jorisdobbelsteen/SpinningLED/Axis/Axis-STM32F411/Images/black_and_white_cat.jpg

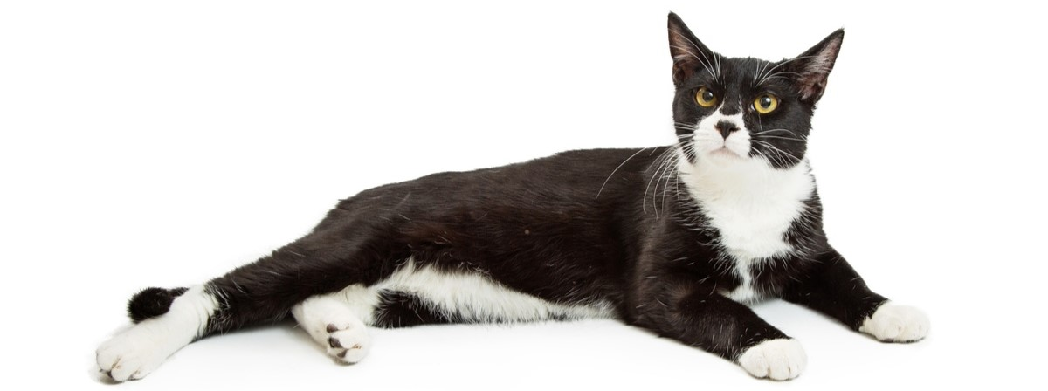
Axis/Axis-STM32F411/Images/black_and_white_cat.jpg
