jorisdobbelsteen/SpinningLED/Documentation/Spinning LED Design Calculations.xlsx

Sheet: Centrifugal Force & Speed
Inputs
Arm Weight | 200 | g | 0.2 | kg
PLA Failure | 40 | MPa |  |  | eSun PLA+ tensile strength is 60 Mpa
PLA support | 225 | mm2 | 0.000225 | m2
PLA force | 9000 | N |  |  | 1 Pa = 1 N/m2
F = mω2r
Centrifugal force (N)
 | Angular velocity
round/sec | 15 | 18 | 20 | 22 | 24 | 25 | 30 | 35 | 40 | 45 | 50
rpm | 900 | 1080 | 1200 | 1320 | 1440 | 1500 | 1800 | 2100 | 2400 | 2700 | 3000
rad/sec | 94.2 | 113.1 | 125.7 | 138.2 | 150.8 | 157.1 | 188.5 | 219.9 | 251.3 | 282.7 | 314.2
Radius (m)
0.2 | 355.3057584 | 511.6402922 | 631.6546817 | 764.3021648 | 909.5827416 | 986.9604401 | 1421.223034 | 1934.442463 | 2526.618727 | 3197.751826 | 3947.84176
0.25 | 444.132198 | 639.5503652 | 789.5683521 | 955.377706 | 1136.978427 | 1233.70055 | 1776.528792 | 2418.053078 | 3158.273408 | 3997.189782 | 4934.802201
0.3 | 532.9586377 | 767.4604382 | 947.4820225 | 1146.453247 | 1364.374112 | 1480.44066 | 2131.834551 | 2901.663694 | 3789.92809 | 4796.627739 | 5921.762641
0.35 | 621.7850773 | 895.3705113 | 1105.395693 | 1337.528788 | 1591.769798 | 1727.18077 | 2487.140309 | 3385.27431 | 4421.582772 | 5596.065695 | 6908.723081
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
