jorisdobbelsteen/SpinningLED/CAD/KiCAD/kicad_templates/Alchitry_Au/meta/board.png

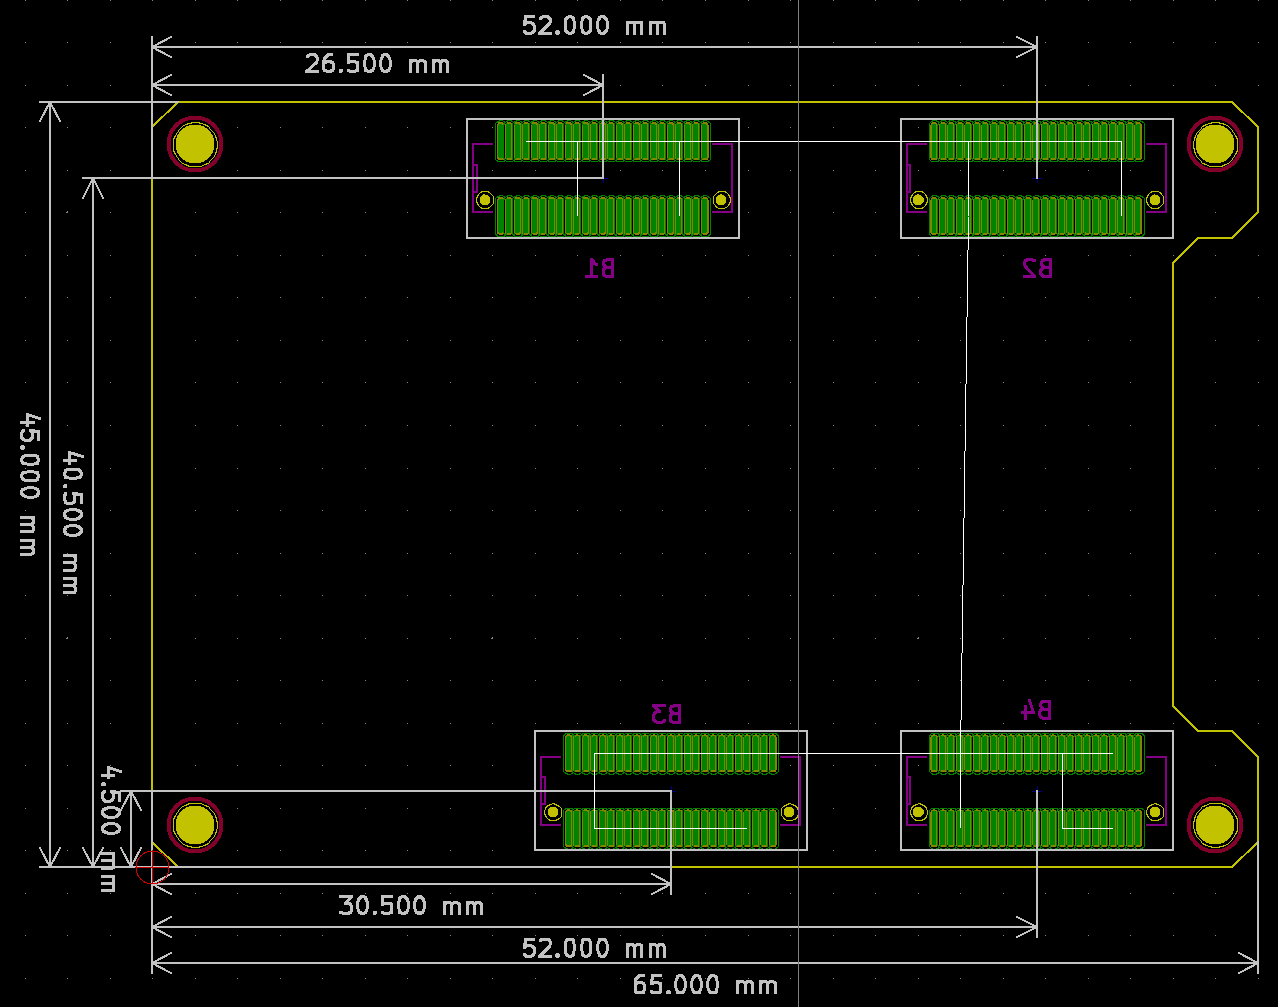
CAD/KiCAD/kicad_templates/Alchitry_Au/meta/board.png
