jorisdobbelsteen/SpinningLED/CAD/KiCAD/kicad_templates/Sierra 2 layer Board/meta/Images/schematic.jpg

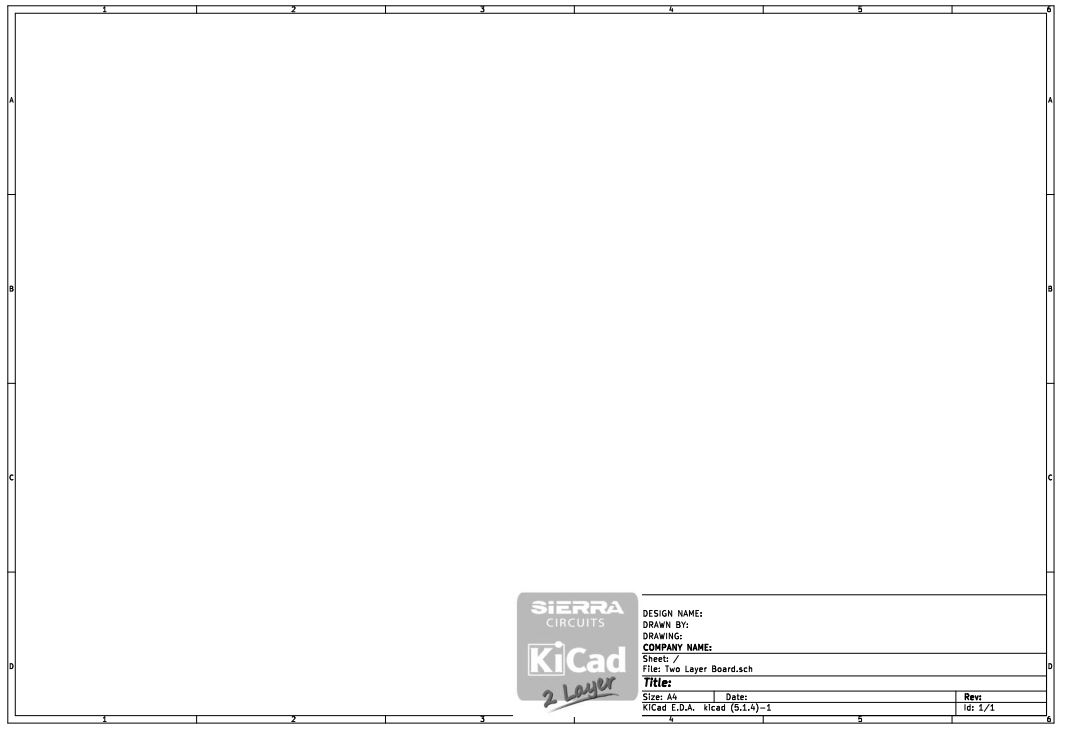
CAD/KiCAD/kicad_templates/Sierra 2 layer Board/meta/Images/schematic.jpg
