jorisdobbelsteen/SpinningLED/CAD/KiCAD/kicad_templates/Sierra 2 layer Board/meta/Images/Text & Graphics.JPG

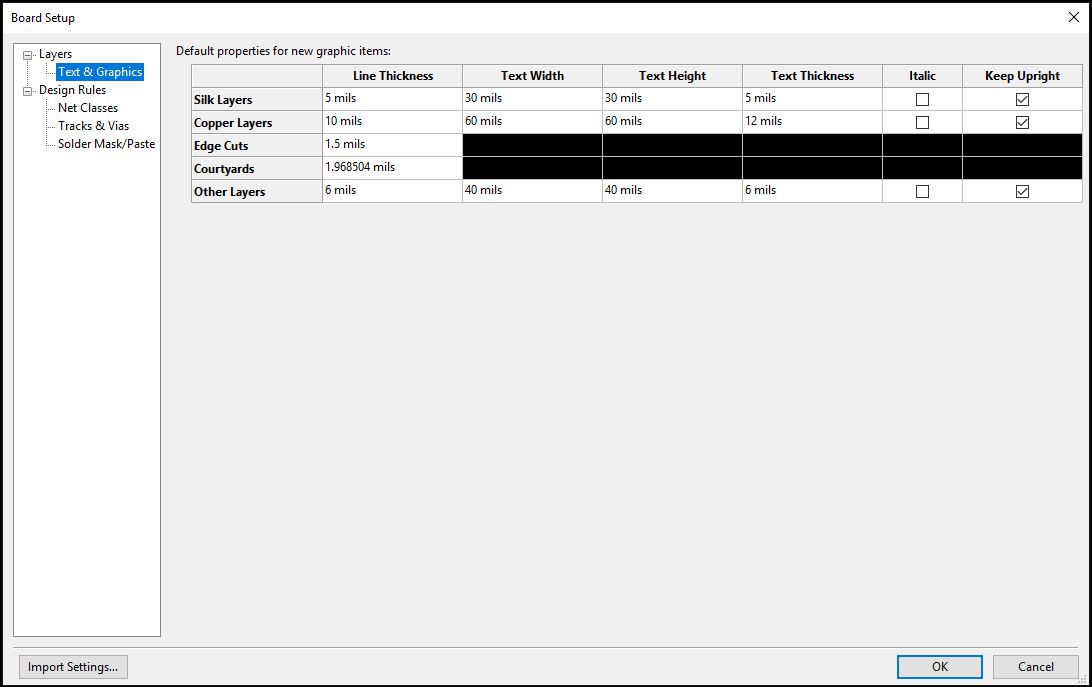
CAD/KiCAD/kicad_templates/Sierra 2 layer Board/meta/Images/Text & Graphics.JPG
