jorisdobbelsteen/SpinningLED/CAD/KiCAD/kicad_templates/Sierra 2 layer Board/meta/Images/Trace & Vias.JPG

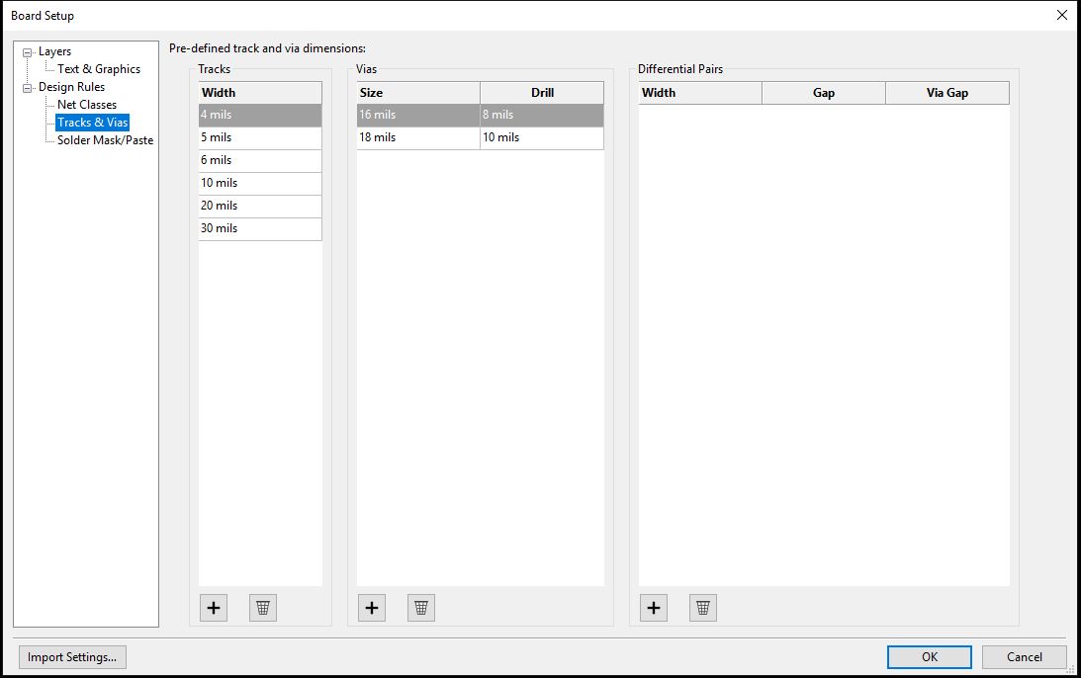
CAD/KiCAD/kicad_templates/Sierra 2 layer Board/meta/Images/Trace & Vias.JPG
