jorisdobbelsteen/SpinningLED/CAD/KiCAD/kicad_templates/Sierra 6 layer Board/meta/Images/Layers.JPG

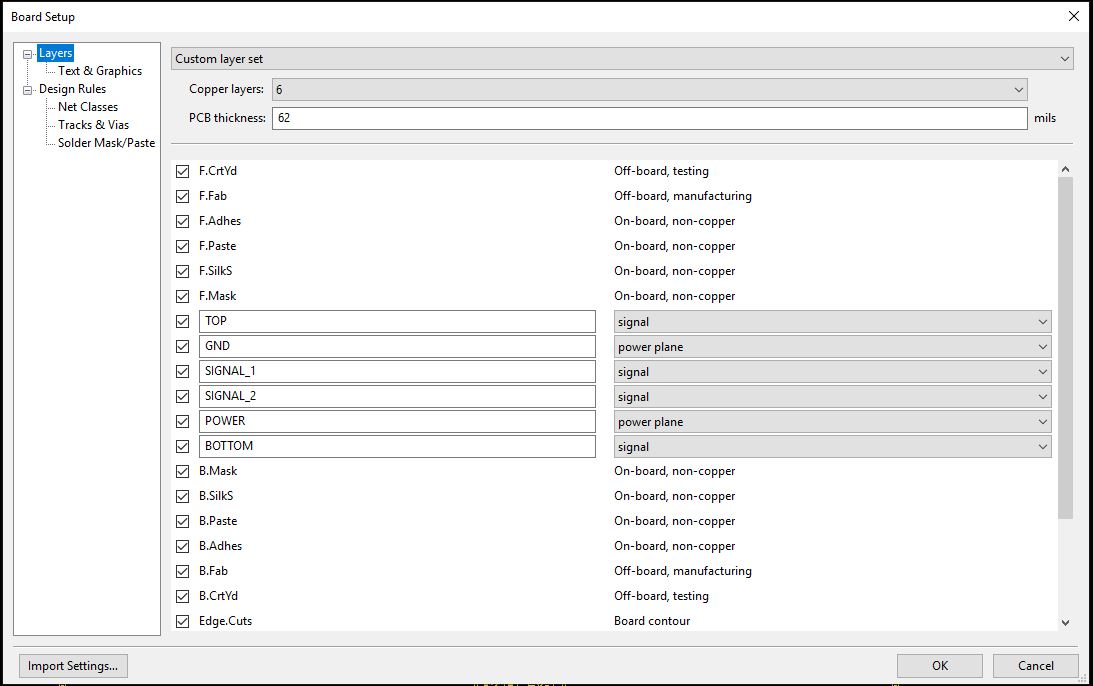
CAD/KiCAD/kicad_templates/Sierra 6 layer Board/meta/Images/Layers.JPG
