jorisdobbelsteen/SpinningLED/CAD/KiCAD/kicad_templates/Sierra 8 layer Board/meta/Images/layout.jpg

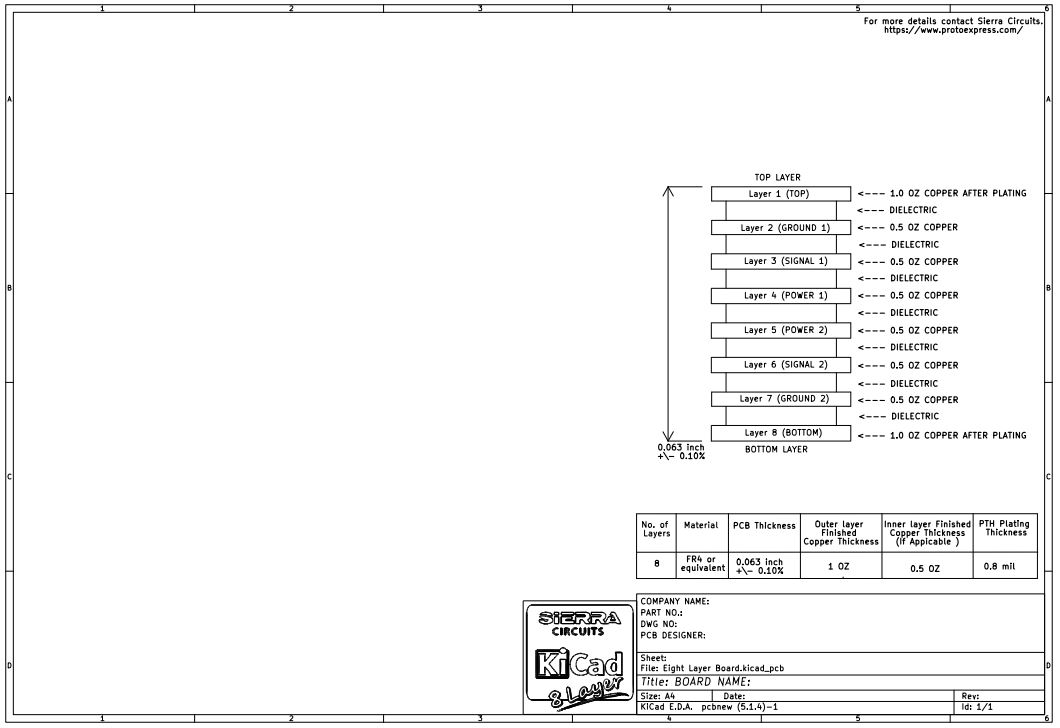
CAD/KiCAD/kicad_templates/Sierra 8 layer Board/meta/Images/layout.jpg
