jorisdobbelsteen/SpinningLED/Boards/AxisPCB/AxisPCB-STM32F411/AxisPCB-STM32F411.kicad_pcb

## KiCad design Boards/AxisPCB/AxisPCB-STM32F411/AxisPCB-STM32F411.kicad_pcb (2023-06-07)

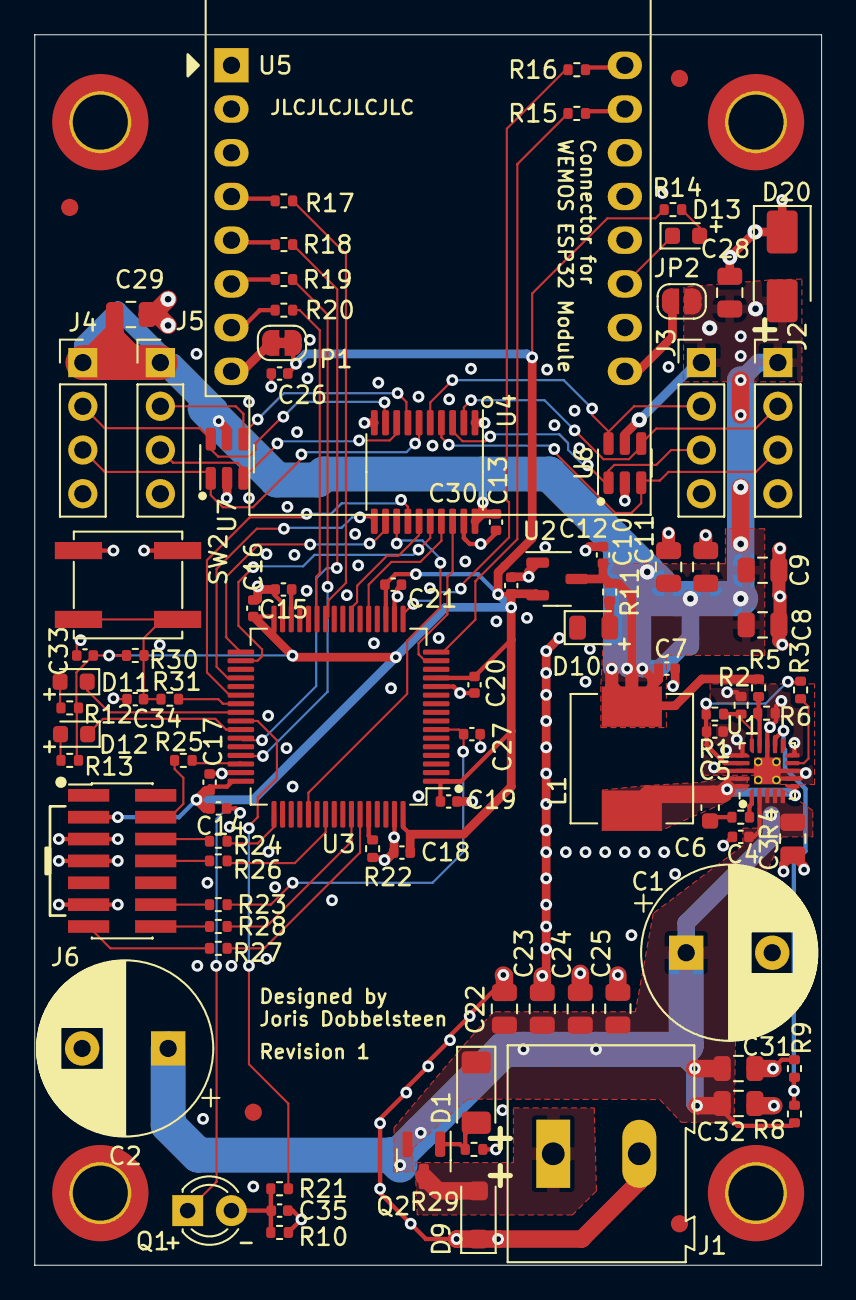
[picture p18: board AxisPCB-STM32F411.kicad_pcb from above]

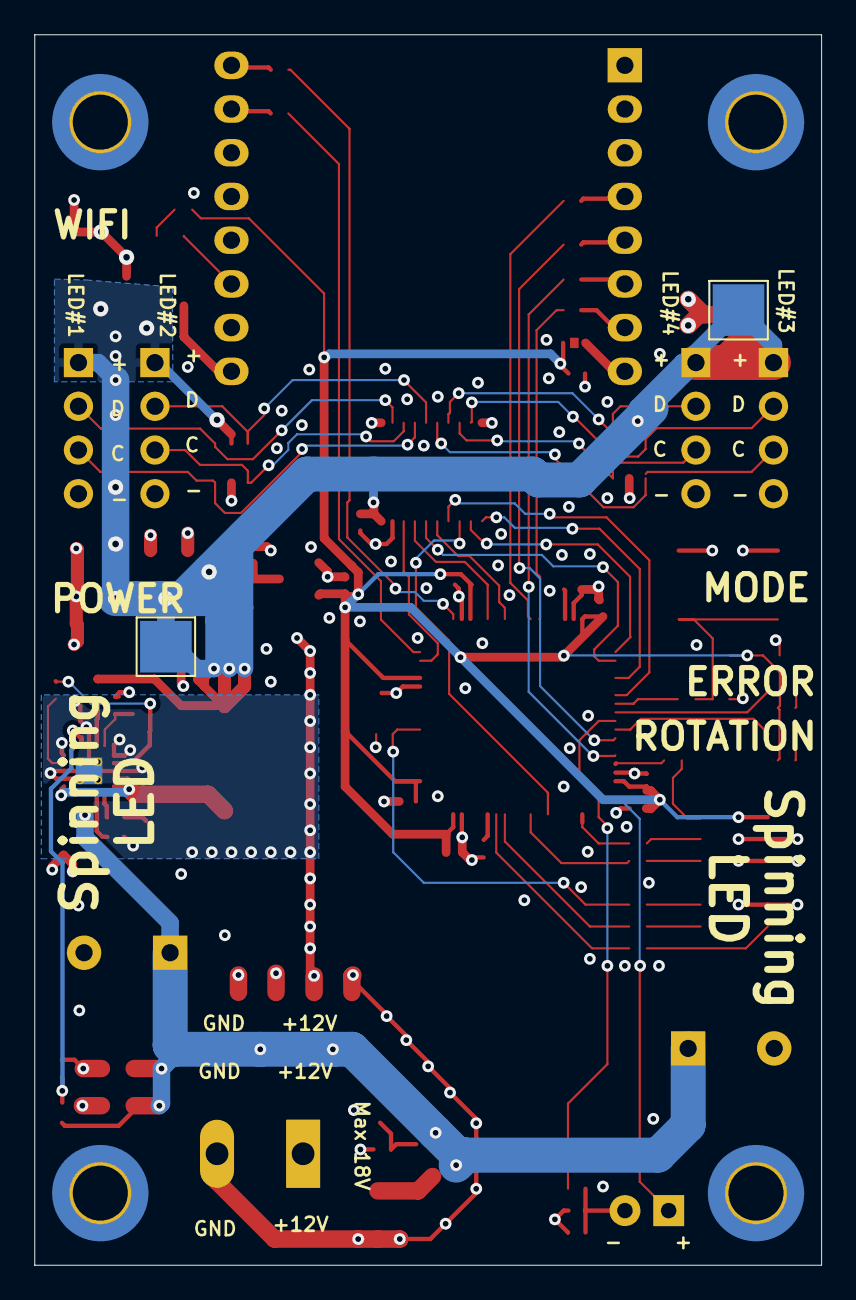
[picture p19: board AxisPCB-STM32F411.kicad_pcb from below]

Board: 4 copper layers, 45.7 x 71.5 mm, 101 parts (2 on the bottom side), 69 nets.

Parts:
C1, C2: 470u; CP_Radial_D10.0mm_P5.00mm
C3, C22, C23, C24, C25, C31, C32: 22u; C_0805_2012Metric
C4, C5, C12, C13, C33: 1u; C_0402_1005Metric
C6: 4u7; C_0603_1608Metric
C7, C16, C17, C18, C19, C20, C21, C27, C30, C34, C35: 0.1u; C_0402_1005Metric
C8, C9, C10, C11, C28, C29: 47u; C_0805_2012Metric
C14, C15, C26: 4.7u; C_0402_1005Metric
D1: ZMM5V6-M; D_MiniMELF
D9: SMF30CA; D_SOD-123F
D10: GREEN LED; LED_0805_2012Metric
D11: RED LED; LED_0603_1608Metric
D12: YELLOW LED; LED_0603_1608Metric
D13: BLUE LED; LED_0603_1608Metric
D20: SMAJ5.0A; D_SMA
FID1, FID2, FID3, FID4: Fiducial; Fiducial_1mm_Mask2mm
H1, H2, H3, H4: M3 Hole; MountingHole_3.2mm_M3_DIN965_Pad_TopBottom
J1: Conn_01x02_Pin; TerminalBlock_Altech_AK300-2_P5.00mm
J2, J3, J4, J5: Conn_01x04; PinHeader_1x04_P2.54mm_Vertical
J6: Conn_ST_STDC14; PinHeader_2x07_P1.27mm_Vertical_SMD
JP1: SolderJumper_2_Bridged; SolderJumper-2_P1.3mm_Bridged_RoundedPad1.0x1.5mm
JP2: SolderJumper_2_Open; SolderJumper-2_P1.3mm_Open_RoundedPad1.0x1.5mm
L1: 1.5u; L_Sunlord_MWSA0603S
Q1: INL-3APT30; LED_D3.0mm_Clear
Q2: AO3401A; SOT-23
R1: 330k 1%; R_0402_1005Metric
R2: 15k 1%; R_0402_1005Metric
R3: 100k; R_0402_1005Metric
R4: 0R; R_0402_1005Metric
R5: 200k 1%; R_0402_1005Metric
R6: 27k 1%; R_0402_1005Metric
R8: 200k; R_0402_1005Metric
R9: 51k; R_0402_1005Metric
R10, R29: 2K; R_0402_1005Metric
R11: 2.4k; R_0402_1005Metric
R12, R14, R31: 680R; R_0402_1005Metric
R13: 1.5k; R_0402_1005Metric
R15, R16, R17, R18, R19, R20, R23, R24, R25, R26: 22R; R_0402_1005Metric
R21, R27, R28: 100R; R_0402_1005Metric
R22, R30: 10k; R_0402_1005Metric
SW2: USER; SW_SPST_EVPBF
TP1, TP2: VCC; TestPoint_Pad_3.0x3.0mm
U1: TPS51396ARJER; VQFN-20-1EP_3x3mm_P0.45mm_EP1.55x1.55mm_ThermalVias
U2: XC6206P332MR; SOT-23-3
U3: STM32F411R_C-E_Tx; LQFP-64_10x10mm_P0.5mm
U4: 74AHCT245PW; TSSOP-20_4.4x6.5mm_P0.65mm
U5: WeMos_D1_mini; WEMOS_D1_mini_light
U6, U7: SRV05-4; SOT-23-6

Connections:
+3.3V: C13.1, C14.1, C16.2, C17.1, C18.1, C19.1, C20.1, C21.1, C26.1, C33.1, J6.3 (VCC), JP1.1 (A), Q1.1 (C), R12.1, R13.2, R14.2, R30.1, U2.2 (VO), U3.1 (VBAT), U3.13 (VDDA), U3.19 (VDD), U3.32 (VDD), U3.48 (VDD), U3.64 (VDD)
+5V: C7.1, C8.1, C9.1, C10.1, C11.1, C12.1, C28.1, C29.1, C30.1, D20.2 (A2), J2.1, J3.1, J4.1, J5.1, JP2.1 (A), L1.2, R5.1, R11.1, TP1.1, TP2.1, U2.3 (VI), U4.20 (VCC), U6.5 (VP), U7.5 (VP)
+12V: C1.1, C2.1, C3.1, C4.1, C22.1, C23.1, C24.1, C25.1, C31.1, C32.1, D1.1 (K), Q2.2 (S), R8.1, U1.2 (VIN), U1.3 (VIN_2), U1.4 (VIN_3), U1.5 (VIN_4)
/+12V_PIN: D9.2 (A2), J1.1, Q2.3 (D)
/SMPS 5V 8A/SW: C6.1, L1.1, U1.6 (SW), U1.19 (SW_2), U1.20 (SW_3)
/SMPS 5V 8A/VCC: C5.1, R1.1, R3.1, U1.17 (VCC)
BOOT0: R22.1, U3.60 (BOOT0)
ERROR_LED: D11.1 (K), U3.40 (PC9)
GND: C1.2, C2.2, C3.2, C4.2, C5.2, C7.2, C8.2, C9.2, C10.2, C11.2, C12.2, C13.2, C14.2, C15.2, C16.1, C17.2, C18.2, C19.2, C20.2, C21.2, C22.2, C23.2, C24.2, C25.2, C26.2, C27.2, C28.2, C29.2, C30.2, C31.2, C32.2, C33.2, C34.2, C35.1, D9.1 (A1), D10.1 (K), D20.1 (A1), H1.1, H2.1, H3.1, H4.1, J1.2, J2.4, J3.4, J4.4, J5.4, J6.5 (GND), J6.7 (GND), J6.11 (GNDDetect), R2.2, R6.2, R9.2, R10.2, R22.2, R29.2, SW2.1, U1.7 (GND), U1.8 (GND_2), U1.10 (NC_1), U1.13 (AGND), U1.16 (NC_2), U1.18 (GND_3), U1.21 (GND_4), U2.1 (GND), U3.12 (VSSA), U3.18 (VSS), U3.31 (VSS), U3.47 (VSS), U3.63 (VSS), U4.1 (A->B), U4.10 (GND), U4.19 (CE), U5.10 (GND), U6.2 (VN), U7.2 (VN)
LS1_C: J2.3, U4.4 (A2), U6.3 (IO2)
LS1_D: J2.2, U4.2 (A0), U6.4 (IO3)
LS2_C: J3.3, U4.3 (A1), U6.1 (IO1)
LS2_D: J3.2, U4.5 (A3), U6.6 (IO4)
LS3_C: J4.3, U4.6 (A4), U7.1 (IO1)
LS3_D: J4.2, U4.9 (A7), U7.6 (IO4)
LS4_C: J5.3, U4.8 (A6), U7.3 (IO2)
LS4_D: J5.2, U4.7 (A5), U7.4 (IO3)
NRST: C27.1, R23.1, U3.7 (NRST)
unnamed: C6.2, R4.2
unnamed: C34.1, R30.2, R31.2, SW2.2
unnamed: D1.2 (A), Q2.1 (G), R29.1
unnamed: D10.2 (A), R11.2
unnamed: D11.2 (A), R12.2
unnamed: D12.2 (A), R13.1
unnamed: D13.2 (A), R14.1
unnamed: J6.6 (JCLK/SWCLK), R24.2
unnamed: J6.8 (JTDO/SWO), R26.2
unnamed: J6.4 (JTMS/SWDIO), R25.2
unnamed: J6.13 (VCP_RX), R27.1
unnamed: J6.14 (VCP_TX), R28.1
unnamed: J6.12 (~RST), R23.2
unnamed: JP1.2 (B), U5.8 (3V3)
unnamed: JP2.2 (B), U5.9 (5V)
unnamed: C35.2, Q1.2 (E), R10.1, R21.1
unnamed: R4.1, U1.1 (BST)
unnamed: R5.2, R6.1, U1.14 (FB)
unnamed: R1.2, R2.1, U1.15 (MODE)
unnamed: R3.2, U1.9 (PGOOD)
unnamed: C15.1, U3.30 (VCAP1)
unnamed: R20.2, U5.7 (CS/D8)
unnamed: R18.2, U5.5 (MISO/D6)
unnamed: R19.2, U5.6 (MOSI/D7)
unnamed: R15.1, U5.15 (RX)
unnamed: R17.2, U5.4 (SCK/D5)
unnamed: R16.2, U5.16 (TX)
ROTATION_LED: D12.1 (K), U3.42 (PA9)
ROT_DETECT: R21.2, U3.41 (PA8)
SMPS_EN: R8.2, R9.1, U1.12 (EN)
SPI1_MOSI: U3.23 (PA7), U4.15 (B3)
SPI1_SCK: U3.21 (PA5), U4.17 (B1)
SPI2_MOSI: U3.36 (PB15), U4.11 (B7)
SPI2_SCK: U3.38 (PC7), U4.14 (B4)
SPI3_MOSI: U3.53 (PC12), U4.13 (B5)
SPI3_SCK: U3.33 (PB12), U4.12 (B6)
SPI4_MOSI: U3.15 (PA1), U4.18 (B0)
SPI4_SCK: U3.34 (PB13), U4.16 (B2)
SPI5_MISO: R19.1, U3.45 (PA12)
SPI5_MOSI: R18.1, U3.43 (PA10)
SPI5_NSS: R20.1, U3.27 (PB1)
SPI5_SCK: R17.1, U3.26 (PB0)
SWD_SWO: R26.1, U3.55 (PB3)
SWD_TCK: R24.1, U3.49 (PA14)
SWD_TMS: R25.1, U3.46 (PA13)
USART1_RX: R27.2, U3.59 (PB7)
USART1_TX: R28.2, U3.58 (PB6)
USART2_RX: R16.1, U3.17 (PA3)
USART2_TX: R15.2, U3.16 (PA2)
USER: R31.1, U3.39 (PC8)
WIFI_STAT_LED: D13.1 (K), U5.11 (D4)
