jorisdobbelsteen/SpinningLED/MotorController/MotorPWM-STM32F303/Core/Src/main.c

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
/* Includes ------------------------------------------------------------------*/
#include "main.h"

/* USER CODE BEGIN Includes */
#include <stdio.h>
#include "button.h"
#include "status_led.h"
#include "motor_control.h"
#include "rotation_sensor.h"
#include "PID.h"
/* USER CODE END Includes */

/* USER CODE BEGIN PTD */
typedef enum state_t {
  /* Note: FATAL_ERROR is handled by program counter, stuck in ErrorHandler() */
  /* STATE               PWM        LED               NEXT_STATE                             */
  STATE_ERROR,        // off        ERROR             btn_stop                  -> STOPPED
  STATE_INIT,         // off        INIT              both_button && powercycle -> CALIBRATE
                      //                              else                      -> STOPPED
  STATE_CALIBRATION,  // on (max)   TROTTLE_CALIB     !both_button              -> STOPPED
                      //                              break                     -> ERROR
  STATE_STOP,         // on (min)   STOPPING /        start_pressed             -> START
                      //            STOPPED           break                     -> ERROR
  STATE_START         // on (PID)   STARTING /        stop_pressed              -> STOP
                      //            STARTED           out_of_limits             -> ERROR
                      //                              break                     -> ERROR
} state_t;
/* USER CODE END PTD */

/* USER CODE BEGIN PD */
#define PULSES_PER_ROTATION 12
#define ROTATIONS_PER_SEC 15
#define RAMP_PULSE_PER_SEC (PULSES_PER_ROTATION * 1 / 4)
#define OVERSPEED_PULSES_PER_SEC (10 * PULSES_PER_ROTATION)
#define UNDERSPEED_PULSES_PER_SEC (10 * PULSES_PER_ROTATION)
#define STABLE_PULSES_PER_SEC (PULSES_PER_ROTATION / 2)
#define PID_PRESCALER 4

/* USER CODE END PD */

TIM_HandleTypeDef htim2;
TIM_HandleTypeDef htim3;
TIM_HandleTypeDef htim6;
TIM_HandleTypeDef htim15;
TIM_HandleTypeDef htim17;

UART_HandleTypeDef huart2;
DMA_HandleTypeDef hdma_usart2_tx;

/* USER CODE BEGIN PV */
static state_t global_state;
static int init_allow_calibration;
static uint32_t init_enter_tick;
static PIDController control_pid;
static volatile unsigned int control_pid_tick_counter;
static unsigned int control_pid_last_tick_counter;
static volatile int control_setpoint_millipulsesec;
static volatile int control_error;
static volatile int control_stable;
static int control_last_pulse_count;
static int control_setpoint_internal_millipulsesec;
static int control_prescaler_pid;
static int start_stop_stable;
/* USER CODE END PV */

void SystemClock_Config(void);
static void MX_GPIO_Init(void);
static void MX_DMA_Init(void);
static void MX_TIM17_Init(void);
static void MX_USART2_UART_Init(void);
static void MX_TIM2_Init(void);
static void MX_TIM3_Init(void);
static void MX_TIM15_Init(void);
static void MX_TIM6_Init(void);
/* USER CODE BEGIN 0 */

static void PID_init(void) {
  control_pid.Kp = 0.060f;
  control_pid.Ki = 0.006f;
  control_pid.Kd = 0.003f;
  control_pid.tau = 0.4f;              // derivative filter time constant
  control_pid.limMin = 0.0f;
  control_pid.limMax = 0.4f;           // cap of output power
  control_pid.limMinInt = -0.1f;
  control_pid.limMaxInt = 0.4f;
  control_pid.T = 0.02f * PID_PRESCALER;

  PIDController_Init(&control_pid);

  control_error = 0;
  control_stable = 0;
  control_setpoint_millipulsesec = 0;
  control_setpoint_internal_millipulsesec = 0;
}

static void PID_tick(void) {
  control_pid_tick_counter++;

  // Load from volatile value
  int final_setpoint = control_setpoint_millipulsesec;

  // Slowly ramp to final setpoint
  int setpoint_e = final_setpoint - control_setpoint_internal_millipulsesec;
  int increment = RAMP_PULSE_PER_SEC * 1000 * control_pid.T;
  int decrement = -5 * RAMP_PULSE_PER_SEC * 1000 * control_pid.T;
  if (setpoint_e > increment)
    setpoint_e = increment;
  else if (setpoint_e < decrement)
    setpoint_e = decrement;
  control_setpoint_internal_millipulsesec += setpoint_e;

  // Acquire current speed
  int millipulses_per_sec = rotation_sensor_get_millipulses_per_sec();
  // Derive from measured ticks
  //
  // Unless the PULSES_PER_ROTATION or measurement period is large enough, this is rather inaccurate...
  // For PULSES_PER_ROTATION 12:
  //   15 rpm -> 180 ticks / sec = 3.6 ticks / 20 ms     -> 3 ~ 4 ticks gives 12.5 ~ 16.6 rpm
  //                             = 14,4 ticks / 80 ms   -> 14 ~ 15 ticks gives 14.6 ~ 16.6 rpm
  // To calculate
  //   1 tick / t ms / x ticks/rotation = 0.1 rps ->
  //   1 / t / 0.1 = x                            -> x = 10 / t
  //   * 20 ms --> 500 ticks / rotation
  //   * 80 ms --> 125 ticks / rotation
//  uint_rotation_t pc = rotation_sensor_get_counter();
//  uint_rotation_t delta_pulse = pc - control_last_pulse_count;
//  control_last_pulse_count = pc;
//  int millipulses_per_sec_c = 1000 * pc / control_pid.T;

  // Safety/Sanity check
  if (millipulses_per_sec > control_setpoint_internal_millipulsesec + OVERSPEED_PULSES_PER_SEC * 1000
      || millipulses_per_sec + UNDERSPEED_PULSES_PER_SEC * 1000 < control_setpoint_internal_millipulsesec) {
    control_error = 1;
    motor_control_set_pulse(MOTOR_PWM_MIN);
    return;
  }

  // PID loop
  float out = PIDController_Update(&control_pid,
                                   control_setpoint_internal_millipulsesec / (1000.0f * PULSES_PER_ROTATION),
                                   millipulses_per_sec / (1000.0f * PULSES_PER_ROTATION));

  // Set output
  motor_control_set_pulse(MOTOR_PWM_MIN + (int)(out * (MOTOR_PWM_MAX - MOTOR_PWM_MIN)));

  // Determine if loop is stable
  int final_error = millipulses_per_sec - final_setpoint;
  control_stable = final_error > -STABLE_PULSES_PER_SEC * 1000
          && final_error < STABLE_PULSES_PER_SEC * 1000;
}

static void PID_print_stats(void) {
  unsigned int c = control_pid_tick_counter;
  if (c == control_pid_last_tick_counter)
    return;
  control_pid_last_tick_counter = c;

  printf("%03d  m %2.3f e %2.3f o %1.4f   i %1.4f d %1.4f\n",
         c % 1000,
         control_pid.prevMeasurement,
         control_pid.prevError,
         control_pid.out,
         control_pid.integrator,
         control_pid.differentiator);
}

static void enter_state(state_t state) {
  switch (state) {
    case STATE_ERROR:
      status_led_set(STATUS_LED_MODE_ERROR);
      puts("ERROR");
      motor_control_stop();
      break;
    case STATE_INIT:
      status_led_set(STATUS_LED_MODE_INIT);
      puts("INIT");
      init_enter_tick = HAL_GetTick();
      break;
    case STATE_CALIBRATION:
      status_led_set(STATUS_LED_MODE_THROTTLE_CALIB);
      puts("CALIBRATE");
      motor_control_start(MOTOR_PWM_MAX); // Set to maximum speed
      break;
    case STATE_STOP:
      status_led_set(STATUS_LED_MODE_STOPPING);
      puts("STOP");
      start_stop_stable = 0;
      motor_control_start(MOTOR_PWM_MIN); // Set to minimum speed
      break;
    case STATE_START:
      status_led_set(STATUS_LED_MODE_STARTING);
      puts("START");
      start_stop_stable = 0;
      PID_init();
      control_setpoint_millipulsesec = ROTATIONS_PER_SEC * PULSES_PER_ROTATION * 1000;
      control_last_pulse_count = rotation_sensor_get_counter();
      motor_control_start_update_interrupt();
      break;
    // NOTE: Rely on compiler to give warning when this is incomplete
  }
}

static void exit_state(state_t state) {
  switch (state) {
    case STATE_ERROR:
      rotation_sensor_reset();
      break;
    case STATE_INIT:
      init_allow_calibration = 0;
      buttons_reset(); // ignore any pending presses
      break;
    case STATE_CALIBRATION:
      motor_control_set_pulse(MOTOR_PWM_MIN);
      buttons_reset(); // ignore any pending presses
      break;
    case STATE_STOP:
      break;
    case STATE_START:
      motor_control_stop_update_interrupt();
      break;
    // Rely on compiler to give warning when this is incomplete
  }
}

static void set_state(state_t next_state) {
  state_t previous_state = global_state;
  if (next_state != previous_state) {
    // Exit state is not aware which exit is performed
    exit_state(previous_state);
    // In enter_state, we can use "global_state" to get the next state
    enter_state(next_state);
    global_state = next_state;
  }
}

void buttons_start_pressed(void) {
  switch (global_state) {
    case STATE_STOP:
      set_state(STATE_START);
      break;
    default:
      break;
  }
}

void buttons_stop_pressed(void) {
  switch (global_state) {
    case STATE_ERROR:
      set_state(STATE_STOP);
      break;
    case STATE_START:
      set_state(STATE_STOP);
      break;
    default:
      break;
  }
}

void HAL_TIM_PeriodElapsedCallback(TIM_HandleTypeDef *htim)
{
  if (htim == &MotorTimer) {
    if (global_state == STATE_START) { // sanity check if we really should run the PWM
      if (control_error != 0) {
        motor_control_set_pulse(MOTOR_PWM_MIN);
        control_error++;
      } else {
        if (++control_prescaler_pid >= PID_PRESCALER) {
          PID_tick();
        }
      }
    } else {
      Error_Handler();
    }
  } /*else if (htim == &ButtonTimer) {
    IT_buttons_check();
  } */
}

void HAL_TIMEx_BreakCallback(TIM_HandleTypeDef *htim) {
  if (htim == &MotorTimer) {
    IT_motor_control_break();
  }
}

static void loop(void) {
  // Check motor state...
  if (motor_control_get_state() == MOTOR_CONTROL_BREAK) {
    puts("Motor BREAK detected");
    set_state(STATE_ERROR);
  }

  buttons_check();

  switch (global_state) {
    case STATE_INIT:
      // Ticks are in milliseconds
      if (HAL_GetTick() - init_enter_tick > 2000) {
        set_state(STATE_STOP);
      } else if (init_allow_calibration && buttons_both_pressed()) {
        set_state(STATE_CALIBRATION);
      }
      break;
    case STATE_CALIBRATION:
      if (!buttons_both_pressed()) {
        set_state(STATE_STOP);
      }
      break;
    case STATE_STOP: {
      const int stable = rotation_sensor_get_millipulses_per_sec() <= 333; // no pulse for 3 seconds
      if (stable != start_stop_stable) {
        status_led_set(stable ? STATUS_LED_MODE_STOPPED : STATUS_LED_MODE_STOPPING);
        start_stop_stable = stable;
      }
    } break;
    case STATE_START: {
      const int stable = control_stable;
      if (control_error > 5) { // give several pulses to allow setting PWM to minimum
        puts("Control ERROR detected");
        set_state(STATE_ERROR);
      } else  if (stable != start_stop_stable) {
        status_led_set(stable ? STATUS_LED_MODE_STARTED : STATUS_LED_MODE_STARTING);
        start_stop_stable = stable;
      }
      PID_print_stats();
    } break;
    default:
      break;
  }
}

/* USER CODE END 0 */

/**
  * @brief  The application entry point.
  * @retval int
  */
int main(void)
{
  /* MCU Configuration--------------------------------------------------------*/

  /* Reset of all peripherals, Initializes the Flash interface and the Systick. */
  HAL_Init();

  /* USER CODE BEGIN Init */

  HAL_SetTickFreq(HAL_TICK_FREQ_100HZ);

  /* USER CODE END Init */

  /* Configure the system clock */
  SystemClock_Config();

  /* USER CODE BEGIN SysInit */

  init_allow_calibration =
    !__HAL_RCC_GET_FLAG(RCC_FLAG_OBLRST) && // Option Byte Load reset
    // normal start has PIN reset !__HAL_RCC_GET_FLAG(RCC_FLAG_PINRST) && // Pin reset
    !__HAL_RCC_GET_FLAG(RCC_FLAG_PORRST) && // POR/PDR reset.
    !__HAL_RCC_GET_FLAG(RCC_FLAG_SFTRST) &&  // Software reset.
    !__HAL_RCC_GET_FLAG(RCC_FLAG_IWDGRST) && // Independent Watchdog reset.
    !__HAL_RCC_GET_FLAG(RCC_FLAG_WWDGRST) && // Window Watchdog reset.
    !__HAL_RCC_GET_FLAG(RCC_FLAG_LPWRRST); // Low Power Reset
  __HAL_RCC_CLEAR_RESET_FLAGS();

  /* USER CODE END SysInit */

  /* Initialize all configured peripherals */
  MX_GPIO_Init();
  MX_DMA_Init();
  MX_TIM17_Init();
  MX_USART2_UART_Init();
  MX_TIM2_Init();
  MX_TIM3_Init();
  MX_TIM15_Init();
  MX_TIM6_Init();
  /* USER CODE BEGIN 2 */

  PID_init();

  buttons_init();
  status_led_init();
  motor_control_init();
  rotation_sensor_init();

  /* USER CODE END 2 */

  /* Infinite loop */
  /* USER CODE BEGIN WHILE */

  global_state = STATE_INIT;
  enter_state(global_state);

  while (1)
  {
    loop();
    /* USER CODE END WHILE */

    /* USER CODE BEGIN 3 */

    HAL_GPIO_TogglePin(LD3_GPIO_Port, LD3_Pin);
    __WFE();
  }
  /* USER CODE END 3 */
}

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
