jorisdobbelsteen/SpinningLED/Axis/Axis-STM32F411/Axis-STM32F411.ioc

Mcu.UserName=STM32F411RETx
PA1.Signal=SPI4_MOSI
PA10.Signal=SPI5_MOSI
PA12.Signal=SPI5_MISO
PA13.GPIO_Label=TMS
PA13.Signal=SYS_JTMS-SWDIO
PA14.GPIO_Label=TCK
PA14.Signal=SYS_JTCK-SWCLK
PA2.GPIO_Label=USART_TX
PA2.Signal=USART2_TX
PA3.GPIO_Label=USART_RX
PA3.Signal=USART2_RX
PA5.Signal=SPI1_SCK
PA7.Signal=SPI1_MOSI
PA8.GPIO_Label=ROTATION_DETECT
PA8.Signal=S_TIM1_CH1
PA9.GPIO_Label=ROTATION_LED
PA9.Signal=S_TIM1_CH2
PB0.Signal=SPI5_SCK
PB1.GPIO_Label=SPI5_NSS
PB1.Signal=SharedStack_PB1
PB12.Signal=SPI3_SCK
PB13.Signal=SPI4_SCK
PB15.Signal=SPI2_MOSI
PB3.GPIO_Label=SWO
PB3.Signal=SYS_JTDO-SWO
PC12.Signal=SPI3_MOSI
PC7.Signal=SPI2_SCK
PC8.GPIO_Label=MODE_BUTTON
PC8.Signal=GPXTI8
PC9.GPIO_Label=ERROR_LED [TIM3_CH4]
PC9.Signal=S_TIM3_CH4
