jorisdobbelsteen/SpinningLED/Axis/Axis-STM32F411/Core/Src/main.c

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
/* Includes ------------------------------------------------------------------*/
#include "main.h"

/* USER CODE BEGIN Includes */
#include <stdbool.h>
#include "../../../shared/packet.h"
#include "control_if.h"
#include "error_led.h"
#include "leds_driver.h"
#include "leds_color_pattern.h"
#include "leds_image.h"
/* USER CODE END Includes */

/* USER CODE BEGIN PTD */

typedef enum rotation_status_t {
  ROTATION_STATUS_NONE,
  ROTATION_STATUS_SLOW,
  ROTATION_STATUS_NORMAL
} rotation_status_t;

/* USER CODE END PTD */

/* USER CODE BEGIN PD */

#define PROGRAM_DEFAULT AXIS_PROGRAM_IMAGE_RGB565

/* USER CODE END PD */


TIM_HandleTypeDef htim1;
TIM_HandleTypeDef htim2;
TIM_HandleTypeDef htim3;
DMA_HandleTypeDef hdma_tim3_ch4_up;

UART_HandleTypeDef huart2;

/* USER CODE BEGIN PV */

volatile int requested_x;
volatile uint16_t rotation_max_value;
volatile rotation_status_t rotation_status;
axis_program_t current_program;
void (*leds_update)(int x, led_data_buffer_t* buffer) = NULL;

/* USER CODE END PV */

void SystemClock_Config(void);
static void MX_GPIO_Init(void);
static void MX_DMA_Init(void);
static void MX_USART2_UART_Init(void);
static void MX_TIM3_Init(void);
static void MX_SPI1_Init(void);
static void MX_SPI2_Init(void);
static void MX_SPI3_Init(void);
static void MX_SPI4_Init(void);
static void MX_SPI5_Init(void);
static void MX_TIM1_Init(void);
static void MX_TIM2_Init(void);
/* USER CODE BEGIN 0 */

void Pixel_IRQHandler(void) {
  // SPI output
  leds_driver_transmit();

  // Increment current x (LED column) counter
  // NOTE: requested_x is volatile, so ensure there is only a single read & write
  int rx = requested_x + 1;
  if (rx == LEDS_X)
    rx = 0;
  requested_x = rx;

  // TODO: Probably this is not needed as interrupt should ensure WFE is aborted anyways...
  __SEV();
}

void Rotation_Detected_IRQHandler(uint16_t value) {
  // Align value to initial location
  __HAL_TIM_SET_AUTORELOAD(&hTIM_PIXEL, value);
  requested_x = 0;
  // Keep low brightness to make it easier on the eyes
  rotation_status = value < rotation_max_value ? ROTATION_STATUS_NORMAL : ROTATION_STATUS_SLOW;
}

void Rotation_None_IRQHandler(void) {
  // Be dim and slow enough for debugging
  __HAL_TIM_SET_AUTORELOAD(&hTIM_PIXEL, 0x1fffff);
  rotation_status = ROTATION_STATUS_NONE;
}

static void Program_Set_I(enum axis_program_t program, bool safe) {
  switch(program) {
    case AXIS_PROGRAM_HUE: leds_update = &update_leds_hue; break;
    case AXIS_PROGRAM_RGB: leds_update = &update_leds_rgb; break;
    case AXIS_PROGRAM_INTERLACE: leds_update = &update_leds_interlace; break;
    case AXIS_PROGRAM_IMAGE_RGB565: leds_update = &update_leds_image; break;
    default: /* NOTICE: ___ RETURN ___ i.s.o. break SO code below is NOT called! */
      if (safe) Program_Set_I(PROGRAM_DEFAULT, false); else Error_Handler(); return;
  }
  current_program = program;
  control_if_set_program(program);
}

void Program_Set(enum axis_program_t program) {
  Program_Set_I(program, true);
}

static void On_Mode_Button_Pressed(void) {
  switch(current_program) {
    case AXIS_PROGRAM_HUE: Program_Set(AXIS_PROGRAM_RGB);; break;
    case AXIS_PROGRAM_RGB: Program_Set(AXIS_PROGRAM_INTERLACE);; break;
    case AXIS_PROGRAM_INTERLACE: Program_Set(AXIS_PROGRAM_IMAGE_RGB565);; break;
    case AXIS_PROGRAM_IMAGE_RGB565: Program_Set(AXIS_PROGRAM_HUE);; break;
    default: Program_Set(PROGRAM_DEFAULT); break;
  }
}

/* USER CODE END 0 */

/**
  * @brief  The application entry point.
  * @retval int
  */
int main(void)
{
  /* MCU Configuration--------------------------------------------------------*/

  /* Reset of all peripherals, Initializes the Flash interface and the Systick. */
  HAL_Init();

  /* USER CODE BEGIN Init */
  // OpenOCD debugger configured PLL with HSI and 64 MHz speed.
  // SystemClock_Config then fails, due to PLL enabled already. This disabled PLL and forces HSI.
  __HAL_RCC_SYSCLK_CONFIG(RCC_SYSCLKSOURCE_HSI);
  /* USER CODE END Init */

  /* Configure the system clock */
  SystemClock_Config();

  /* Initialize all configured peripherals */
  MX_GPIO_Init();
  MX_DMA_Init();
  MX_USART2_UART_Init();
  MX_TIM3_Init();
  MX_SPI1_Init();
  MX_SPI2_Init();
  MX_SPI3_Init();
  MX_SPI4_Init();
  MX_SPI5_Init();
  MX_TIM1_Init();
  MX_TIM2_Init();
  /* USER CODE BEGIN 2 */

  // Indicate the device is 'alive'...
  error_led_init();

  Program_Set(PROGRAM_DEFAULT);
  if (leds_update == NULL) {
    Error_Handler();
  }

  control_if_init();
  control_if_set_program(current_program);

  // This assumes all timers run at the HCLK frequency (even on the slower bus).
  {
    uint32_t rotation_ticks_per_sec = SystemCoreClock / (hTIM_ROTATION.Init.Prescaler+1);
    rotation_max_value = rotation_ticks_per_sec / ROTATION_MIN_RPM;

    HAL_TIM_IC_Start(&hTIM_ROTATION, TIM_ROTATION_CHANNEL_DETECT);
    HAL_TIM_PWM_Start(&hTIM_ROTATION, TIM_ROTATION_CHANNEL_LED);
    __HAL_TIM_SET_COMPARE(&hTIM_ROTATION, TIM_ROTATION_CHANNEL_LED,
                          ROTATION_LED_PULSE_MS * rotation_ticks_per_sec / 1000);
    HAL_TIM_Base_Start_IT(&hTIM_ROTATION);
  }

  leds_driver_init();
  update_leds_image_init();

  // Start pixel timer
  HAL_TIM_Base_Start_IT(&hTIM_PIXEL);

  /* USER CODE END 2 */

  /* Infinite loop */
  /* USER CODE BEGIN WHILE */

  int current_x = -1;
  int late = 0;
  while (1) {
    // Check if current line has changed. If so, render new color onto it
    int rx = requested_x;
    if (rx != current_x) {
      // Request pixel update (priority!)

      // Performance measurement, start timing
      uint32_t start_tick = SysTick->VAL;

      current_x = rx;
      leds_update(current_x, leds_driver_get_next_buffer());

      // Performance measurement, end timing
     uint32_t end_tick = SysTick->VAL;

     // Check if we are late, either by interrupt or systick
      if (rx != requested_x) {
        // Definitely late, mark this event!
        late++;
      } else {
        // Calculate using systick counter for 16 rpm
        uint32_t ticks;
        if (start_tick > end_tick) {
          ticks = start_tick - end_tick;
        } else {
          ticks = start_tick - end_tick + SysTick->LOAD;
        }

        if (ticks >= SystemCoreClock / (LEDS_X * 26)) {
          late++;
        }
      }
    }

    // Update brightness of LEDs
    leds_driver_set_brightness(rotation_status == ROTATION_STATUS_NORMAL
                               ? BRIGHTNESS_DEFAULT : BRIGHTNESS_NODETECT);

    // Update error led based on various status
    if (late) {
      error_led_set(AXIS_ERROR_LATE);
    } else {
      if (rotation_status == ROTATION_STATUS_NONE) {
        error_led_set(AXIS_ERROR_NO_ROTATION);
      } else {
        error_led_set(AXIS_ERROR_OK);
      }
    }

    // Check for mode button pressed
    if (EXTI->PR & MODE_BUTTON_Pin) {
      // Mode button event triggered. Write to clear it.
      EXTI->PR = MODE_BUTTON_Pin;

      On_Mode_Button_Pressed();
      late = 0;
    }

    control_if_process();

    __WFE();
    /* USER CODE END WHILE */

    /* USER CODE BEGIN 3 */
  }
  /* USER CODE END 3 */
}

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
