jorisdobbelsteen/SpinningLED/Axis/Axis-STM32F411/Core/Inc/main.h

#define FOUR_CHANNEL 0
#define BRIGHTNESS_DEFAULT 0x80
#define BRIGHTNESS_NODETECT 0x08
#define ROTATION_MIN_RPM 13
#define hLEDS1_TXDMA_STREAM LL_DMA_STREAM_1
#define hLEDS4 SPI3
#define hLEDS3_TXDMA_STREAM LL_DMA_STREAM_4
#define hLEDS3 SPI2
#define hLEDS4_TXDMA_STREAM LL_DMA_STREAM_5
#define hLEDS2 SPI1
#define hLEDS1 SPI4
#define TIM_ERROR_CHANNEL_LED TIM_CHANNEL_4
#define hLEDS4_TXDMA DMA1
#define hLEDS2_TXDMA_STREAM LL_DMA_STREAM_2
#define hLEDS2_TXDMA DMA2
#define TIM_ROTATION_CHANNEL_LED TIM_CHANNEL_2
#define hTIM_PIXEL htim2
#define hLEDS3_TXDMA DMA1
#define hTIM_ERROR htim3
#define TIM_ROTATION_CHANNEL_DETECT TIM_CHANNEL_1
#define hLEDS1_TXDMA DMA2
#define hTIM_ROTATION htim1
#define ROTATION_LED_PULSE_MS 5
#define LEDS_X 400
#define LEDS_Y 57
#define SPI5_TXDMA DMA2
#define SPI5_RXDMA DMA2
#define SPI5_RXDMA_STREAM LL_DMA_STREAM_3
#define SPI5_TXDMA_STREAM LL_DMA_STREAM_4
#define USART_TX_Pin GPIO_PIN_2
#define USART_TX_GPIO_Port GPIOA
#define USART_RX_Pin GPIO_PIN_3
#define USART_RX_GPIO_Port GPIOA
#define SPI5_NSS_Pin GPIO_PIN_1
#define SPI5_NSS_GPIO_Port GPIOB
#define MODE_BUTTON_Pin GPIO_PIN_8
#define MODE_BUTTON_GPIO_Port GPIOC
#define ERROR_LED_Pin GPIO_PIN_9
#define ERROR_LED_GPIO_Port GPIOC
#define ROTATION_DETECT_Pin GPIO_PIN_8
#define ROTATION_DETECT_GPIO_Port GPIOA
#define ROTATION_LED_Pin GPIO_PIN_9
#define ROTATION_LED_GPIO_Port GPIOA
#define TMS_Pin GPIO_PIN_13
#define TMS_GPIO_Port GPIOA
#define TCK_Pin GPIO_PIN_14
#define TCK_GPIO_Port GPIOA
#define SWO_Pin GPIO_PIN_3
#define SWO_GPIO_Port GPIOB
