jorisdobbelsteen/SpinningLED/Axis/Axis-STM32F411/Core/Inc/error_led.h

//
// Created by Joris on 07/08/2023.
//

#ifndef AXIS_STM32F411_ERROR_LED_H
#define AXIS_STM32F411_ERROR_LED_H

typedef enum axis_error_t {
  AXIS_ERROR_OK = 0,
  AXIS_ERROR_FATAL_ERROR,
  AXIS_ERROR_FATAL_FAULT,
  AXIS_ERROR_INIT,
  AXIS_ERROR_NO_ROTATION,
  AXIS_ERROR_LATE,
  AXIS_ERROR_MAX_VALUE
} axis_error_t;

void error_led_init(void);
void error_led_set(axis_error_t error);

#endif //AXIS_STM32F411_ERROR_LED_H
