jorisdobbelsteen/SpinningLED/Axis/Axis-STM32F411/Core/Inc/leds_color_pattern.h

//
// Created by Joris on 01/11/2023.
//

#ifndef AXIS_STM32F411_LEDS_COLOR_PATTERN_H
#define AXIS_STM32F411_LEDS_COLOR_PATTERN_H

#include "leds_driver.h"

void update_leds_hue(int x, led_data_buffer_t* buffer);
void update_leds_rgb(int x, led_data_buffer_t* buffer);
void update_leds_interlace(int x, led_data_buffer_t* buffer);

#endif //AXIS_STM32F411_LEDS_COLOR_PATTERN_H
