jorisdobbelsteen/SpinningLED/(commit log)

2023-06-07 Initial commit * PCB for Axis board, revision 1 * Documentation for design ready * Project setup for axis. No code and pinout not yet aligned with PCB
    [AISLER-2Layer.kicad_pcb, AISLER-2Layer.sch, AISLER-4Layer.kicad_pcb, AISLER-4Layer.sch, Alchitry_Au.kicad_pcb, Alchitry_Au.sch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]
2023-08-09 Axis PCB Errata document added Minor documentation update
2023-08-09 Board bring-up with 2 LED strings
    Drive 2 LED strings of 52 leds with changing hue
    Error LED and rotation LED
    CPU at 80 MHz and SPI busses run at 20 Mbps
    Most peripherals are now configured via STM32CubeMX
    Testing of rotation sensor not performed, as device is not yet onboard
    Testing of SPI5 for ESP32 not done, as ESP32 not installed
    [st_nucleo_f4.cfg]
2023-08-10 Enable all compiler warnings (GCC) and fix code
    [error_led.c, error_led.h, main.c]
2023-08-11 Switch to Low Level drivers rather than HAL
2023-08-11 Drive SPI busses using pixel timer (TIM2) interrupt Main loop can put CPU into sleep mode Interrupts now have preemption so pixel timer will fire reliably
2023-08-12 SPI DMA streams access SRAM with words instead of bytes (using FIFO)
2023-10-21 Control box with PWM signal to separate BLDC controller based on ST Nucleo-F303 development board
    Peripherals and full concept of control loop implemented.
    Actual control is not implemented.
    [st_nucleo_f3.cfg]
2023-10-22 Working speed controller (keeps speed at +/- 0.2 rpm without swinging bars)
2023-10-23 Improve tuning of speed controller PID coefficients to run at 15 rpm
2023-10-25 Axis board: STM32CubeMX 6.9.0 upgrade. Higher LED brightness.
2023-10-31 Better tuning of PID with heavier arms
2023-11-01 Axis board: rotation detect, color scheme, reduced SPI speed
    Rotation detection sensor support.
    Color with Hue & RGB (algorithms).
    Reduce SPI speed to 16 Mbps (processor to 64 MHz).
2023-11-02 Axis board: double buffer SPI and slow update on no rotation
2023-11-02 Axis board: add color patterns and enable mode button
2023-11-02 Axis board: add two-channel and four-channel build config. Fix compile issues with two-channel mode. Update .gitignore.
    [leds_driver.c, leds_driver.h, main.h]
2023-11-07 Axis board: actually working and with cat image Fix mistakes with x & y coordinates and limits. Added cat image (includes generator from image to c code).
    [error_led.c, error_led.h, leds_color_pattern.c, leds_color_pattern.h, leds_image.c, leds_image.h, main.c, main.h]
2024-02-07 Communication via SPI5 to external app
    Enable SPI5 as slave to receive commands. Provides current state (working). Supports setting a program (untested).
    Tune optimization and enable LTO for release build
2024-02-07 Images with converter script
    Allow images to be added to the Axis board build
2024-02-07 Allow Android to Axis MCU communication via ESP32-C3
    Adds platform.io project for this MCU
2024-02-07 Update documentation and design description
    [Spinning LED Design Calculations.xlsx]
