jorisdobbelsteen/SpinningLED/(notices)

Notices in the files:
MotorController/MotorPWM-STM32F303/Core/Src/main.c:
Copyright (c) 2023 Joris Dobbelsteen.
All rights reserved.
Axis/Axis-STM32F411/Core/Src/main.c:
Copyright (c) 2023 STMicroelectronics.
This software is licensed under terms that can be found in the LICENSE file
